ppe/W5300-for-QL/README

Hardware design and drivers for Sinclair QL experimental ethernet card.
