ppe/W5300-for-QL/Hardware/QE_PCB/QE_PCB.kicad_pcb

## KiCad design Hardware/QE_PCB/QE_PCB.kicad_pcb (2023-01-12)

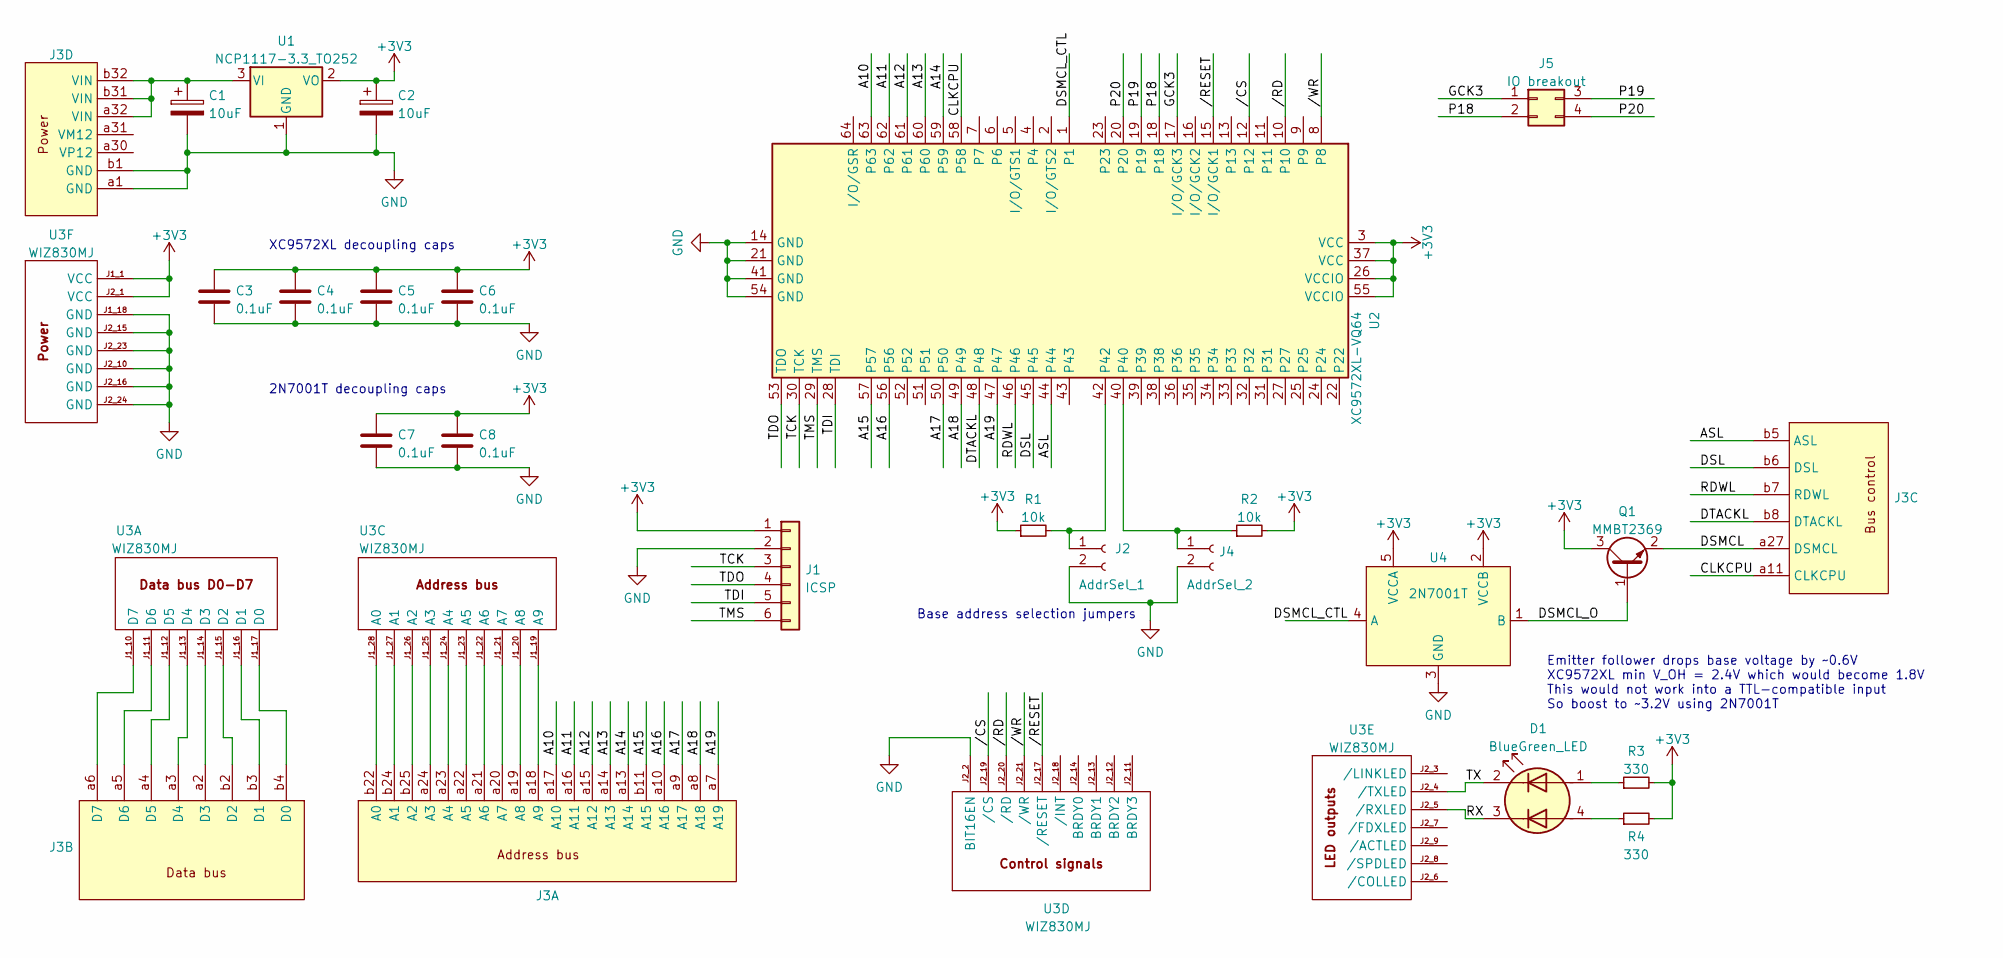
[picture p1: schematic QE_PCB.kicad_sch]

Parts:
C1, C2: 10uF; CP_EIA-6032-20_AVX-F_Pad2.25x2.35mm_HandSolder
C3, C4, C5, C6, C7, C8: 0.1uF; C_0603_1608Metric_Pad1.08x0.95mm_HandSolder
D1: BlueGreen_LED; LED_Dual_BG_2.0x1.25_Kingbright
J1: ICSP; PinHeader_1x06_P2.54mm_Vertical
J2: AddrSel_1; PinHeader_1x02_P2.54mm_Vertical
J3: Expansion_connector; DIN41612_B_2x32_Female_Horizontal_THT
J4: AddrSel_2; PinHeader_1x02_P2.54mm_Vertical
J5: IO breakout; PinHeader_1x04_P2.54mm_Vertical
Q1: MMBT2369; SOT-23
R1, R2: 10k; R_0805_2012Metric_Pad1.20x1.40mm_HandSolder
R3, R4: 330; R_0805_2012Metric_Pad1.20x1.40mm_HandSolder
U1: NCP1117-3.3_TO252; NCP1117 TO-252-2
U2: XC9572XL-VQ64; TQFP-64_10x10mm_P0.5mm
U3: WIZ830MJ
U4: 2N7001T; SOT-353_SC-70-5_Handsoldering

Connections:
+3V3: C2.1, C3.1, C4.1, C5.1, C6.1, C7.1, C8.1, J1.1, Q1.3 (C), R1.1, R2.2, R3.2, R4.2, U1.2 (VO), U2.3 (VCC), U2.26 (VCCIO), U2.37 (VCC), U2.55 (VCCIO), U3.J1_1 (VCC), U3.J2_1 (VCC), U4.2 (VCCB), U4.5 (VCCA)
/A10: J3.a17 (A10), U2.63
/A11: J3.a16 (A11), U2.62
/A12: J3.a15 (A12), U2.61
/A13: J3.a14 (A13), U2.60
/A14: J3.a13 (A14), U2.59
/A15: J3.b11 (A15), U2.57
/A16: J3.a10 (A16), U2.56
/A17: J3.a9 (A17), U2.50
/A18: J3.a8 (A18), U2.49
/A19: J3.a7 (A19), U2.47
/ASL: J3.b5 (ASL), U2.44
/CLKCPU: J3.a11 (CLKCPU), U2.58
/DSL: J3.b6 (DSL), U2.45
/DSMCL: J3.a27 (DSMCL), Q1.2 (E)
/DSMCL_CTL: U2.1, U4.4 (A)
/DSMCL_O: Q1.1 (B), U4.1 (B)
/DTACKL: J3.b8 (DTACKL), U2.48
/GCK3: J5.1, U2.17 (I/O/GCK3)
/P18: J5.2, U2.18
/P19: J5.3, U2.19
/P20: J5.4, U2.20
/RDWL: J3.b7 (RDWL), U2.46
/RX: D1.3 (K2), U3.J2_5 (/RXLED)
/TCK: J1.3, U2.30 (TCK)
/TDI: J1.5, U2.28 (TDI)
/TDO: J1.4, U2.53 (TDO)
/TMS: J1.6, U2.29 (TMS)
/TX: D1.2 (K1), U3.J2_4 (/TXLED)
//CS: U2.12, U3.J2_19 (/CS)
//RD: U2.10, U3.J2_20 (/RD)
//RESET: U2.15 (I/O/GCK1), U3.J2_17 (/RESET)
//WR: U2.8, U3.J2_21 (/WR)
GND: C1.2, C2.2, C3.2, C4.2, C5.2, C6.2, C7.2, C8.2, J1.2, J2.2, J3.a1 (GND), J3.b1 (GND), J4.2, U1.1 (GND), U2.14 (GND), U2.21 (GND), U2.41 (GND), U2.54 (GND), U3.J1_18 (GND), U3.J2_2 (BIT16EN), U3.J2_10 (GND), U3.J2_15 (GND), U3.J2_16 (GND), U3.J2_23 (GND), U3.J2_24 (GND), U4.3 (GND)
unnamed: C1.1, J3.a32 (VIN), J3.b31 (VIN), J3.b32 (VIN), U1.3 (VI)
unnamed: D1.1 (A1), R3.1
unnamed: D1.4 (A2), R4.1
unnamed: J2.1, R1.2, U2.42
unnamed: J3.a2 (D3), U3.J1_14 (D3)
unnamed: J3.a3 (D4), U3.J1_13 (D4)
unnamed: J3.a4 (D5), U3.J1_12 (D5)
unnamed: J3.a5 (D6), U3.J1_11 (D6)
unnamed: J3.a6 (D7), U3.J1_10 (D7)
unnamed: J3.a18 (A9), U3.J1_19 (A9)
unnamed: J3.a19 (A8), U3.J1_20 (A8)
unnamed: J3.a20 (A7), U3.J1_21 (A7)
unnamed: J3.a21 (A6), U3.J1_22 (A6)
unnamed: J3.a22 (A5), U3.J1_23 (A5)
unnamed: J3.a23 (A4), U3.J1_24 (A4)
unnamed: J3.a24 (A3), U3.J1_25 (A3)
unnamed: J3.b2 (D2), U3.J1_15 (D2)
unnamed: J3.b3 (D1), U3.J1_16 (D1)
unnamed: J3.b4 (D0), U3.J1_17 (D0)
unnamed: J3.b22 (A0), U3.J1_28 (A0)
unnamed: J3.b24 (A1), U3.J1_27 (A1)
unnamed: J3.b25 (A2), U3.J1_26 (A2)
unnamed: J4.1, R2.1, U2.40

Notes on the sheet:
Emitter follower drops base voltage by ~0.6V XC9572XL min V_OH = 2.4V which would become 1.8V This would not work into a TTL-compatible input So boost to ~3.2V using 2N7001T
XC9572XL decoupling caps
Base address selection jumpers
2N7001T decoupling caps

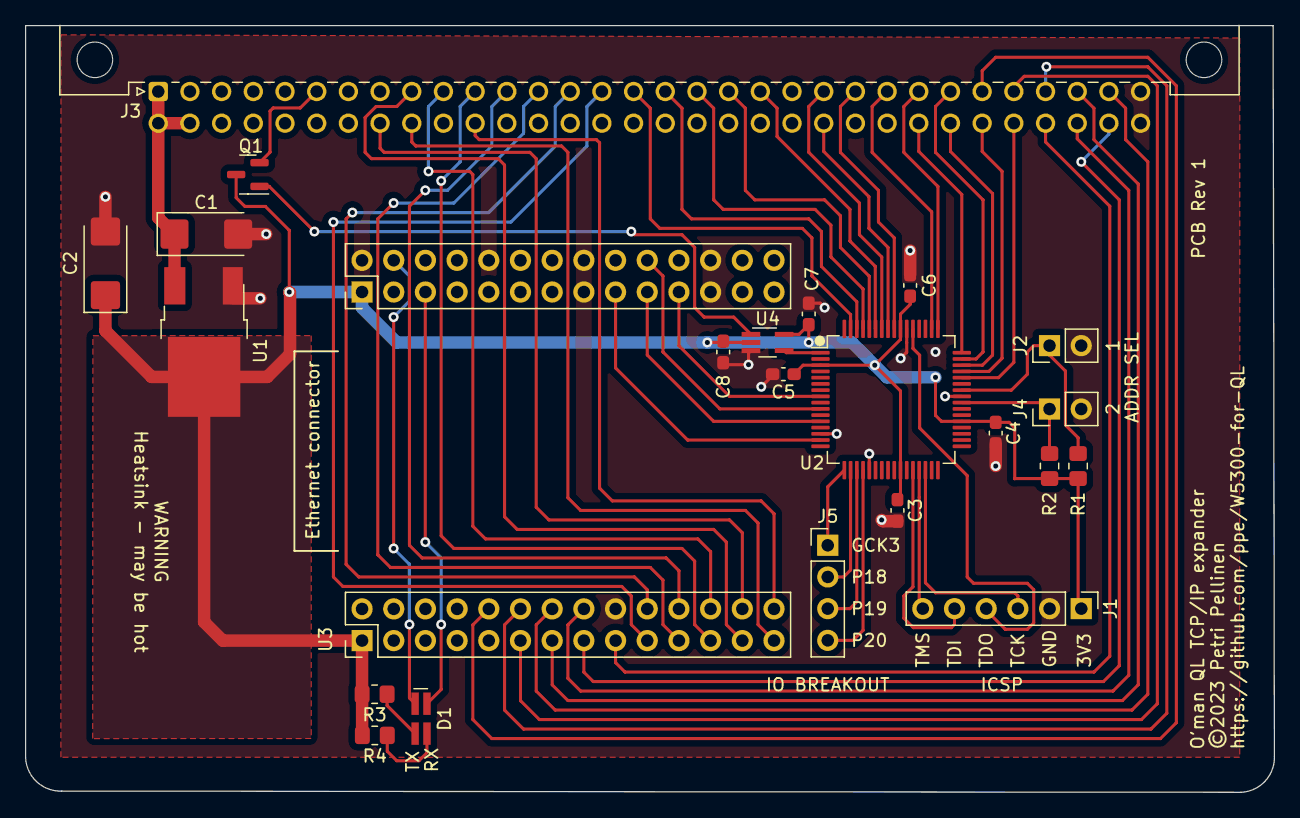
[picture p2: board QE_PCB.kicad_pcb from above]

Board: 2 copper layers, 100.1 x 61.5 mm, 23 parts (0 on the bottom side), 57 nets.
