ppe/W5300-for-QL/Hardware/Eagle/QL Ethernet/qe.brd

## EAGLE design Hardware/Eagle/QL Ethernet/qe.brd (2014-01-23)

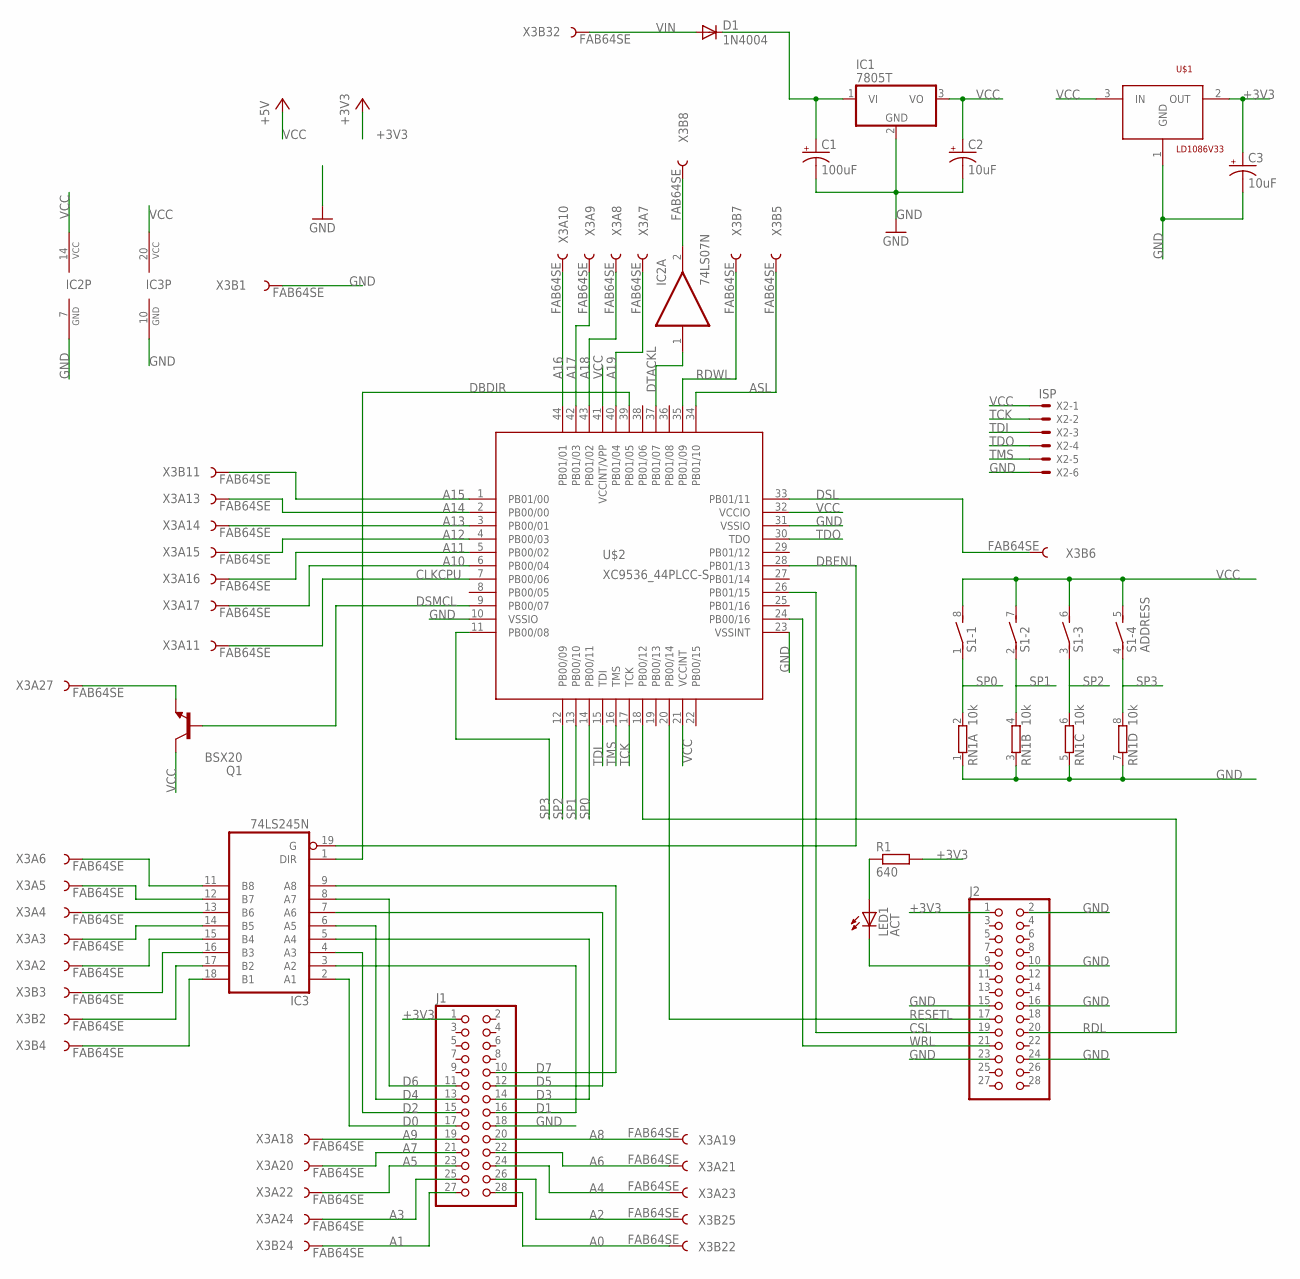
[picture p3: schematic qe.sch]

Parts:
C1: 100uF; TAP5-80
C2, C3: 10uF; TAP5-45
D1: 1N4004; DO41-10
IC1: 7805T; TO220H
IC2: 74LS07N; DIL14
IC3: 74LS245N; DIL20
J1, J2: PINHD-2X14; 2X14
LED1: ACT; LED5MM
Q1: BSX20; TO18
R1: 640; 0204/7
RN1: 10k; SIL8
S1: ADDRESS; DIP04S
U$1: LD1086V33; TO220
U$2: XC9536_44PLCC-S; PLCC44-S
X2: ISP; 22-23-2061
X3: FAB64SE; FAB64S

Connections:
+3V3: C3.+, J1.1, J2.1, R1.2, U$1.2 (OUT)
A0: J1.28, X3.B22
A1: J1.27, X3.B24
A2: J1.26, X3.B25
A3: J1.25, X3.A24
A4: J1.24, X3.A23
A5: J1.23, X3.A22
A6: J1.22, X3.A21
A7: J1.21, X3.A20
A8: J1.20, X3.A19
A9: J1.19, X3.A18
A10: U$2.6 (PB00/04), X3.A17
A11: U$2.5 (PB00/02), X3.A16
A12: U$2.4 (PB00/03), X3.A15
A13: U$2.3 (PB00/01), X3.A14
A14: U$2.2 (PB00/00), X3.A13
A15: U$2.1 (PB01/00), X3.B11
A16: U$2.44 (PB01/01), X3.A10
A17: U$2.42 (PB01/03), X3.A9
A18: U$2.43 (PB01/02), X3.A8
A19: U$2.40 (PB01/04), X3.A7
ASL: U$2.34 (PB01/10), X3.B5
CLKCPU: U$2.7 (PB00/06), X3.A11
CSL: J2.19, U$2.26 (PB01/15)
D0: IC3.2 (A1), J1.17
D1: IC3.3 (A2), J1.16
D2: IC3.4 (A3), J1.15
D3: IC3.5 (A4), J1.14
D4: IC3.6 (A5), J1.13
D5: IC3.7 (A6), J1.12
D6: IC3.8 (A7), J1.11
D7: IC3.9 (A8), J1.10
DBDIR: IC3.1 (DIR), U$2.39 (PB01/05)
DBENL: IC3.19 (G), U$2.28 (PB01/13)
DSL: U$2.33 (PB01/11), X3.B6
DSMCL: Q1.2 (B), U$2.9 (PB00/07)
DTACKL: IC2.1 (I), U$2.37 (PB01/07)
GND: C1.-, C2.-, C3.-, IC1.2 (GND), IC2.7 (GND), IC3.10 (GND), J1.18, J2.2, J2.10, J2.15, J2.16, J2.23, J2.24, RN1.1, RN1.3 (1), RN1.5 (1), RN1.7 (1), U$1.1 (GND), U$2.10 (VSSIO), U$2.23 (VSSINT), U$2.31 (VSSIO), X2.6, X3.B1
unnamed: IC3.11 (B8), X3.A6
unnamed: IC3.12 (B7), X3.A5
unnamed: IC3.13 (B6), X3.A4
unnamed: IC3.14 (B5), X3.A3
unnamed: IC3.15 (B4), X3.A2
unnamed: IC3.16 (B3), X3.B3
unnamed: IC3.17 (B2), X3.B2
unnamed: IC3.18 (B1), X3.B4
unnamed: Q1.1 (E), X3.A27
unnamed: J2.9, LED1.K (C)
unnamed: LED1.A, R1.1
unnamed: D1.A, X3.B32
unnamed: IC2.2 (O), X3.B8
RDL: J2.20, U$2.18 (PB00/12)
RDWL: U$2.35 (PB01/09), X3.B7
RESETL: J2.17, U$2.20 (PB00/14)
SP0: RN1.2, S1.1, U$2.14 (PB00/11)
SP1: RN1.4 (2), S1.2 (1), U$2.13 (PB00/10)
SP2: RN1.6 (2), S1.3 (1), U$2.12 (PB00/09)
SP3: RN1.8 (2), S1.4 (1), U$2.11 (PB00/08)
TCK: U$2.17 (TCK), X2.2
TDI: U$2.15 (TDI), X2.3
TDO: U$2.30 (TDO), X2.4
TMS: U$2.16 (TMS), X2.5
VCC: C2.+, IC1.3 (VO), IC2.14 (VCC), IC3.20 (VCC), Q1.3 (C), S1.5 (2), S1.6 (2), S1.7 (2), S1.8 (2), U$1.3 (IN), U$2.21 (VCCINT), U$2.32 (VCCIO), U$2.41 (VCCINT/VPP), X2.1
VIN: C1.+, D1.C, IC1.1 (VI)
WRL: J2.21, U$2.24 (PB00/16)

Board: 2 copper layers, 18 parts (0 on the bottom side), 65 nets, no tracks yet.
