ppe/W5300-for-QL/(threads)

Thread 2 (2022-12-06):

Problem compiling driver

SM7I, 2022-12-06:
I´m having issues compiling the driver with the docker xora/qdos-gcc. I´ll try it on my full blown compiler later and see if it works there.

ppe, 2022-12-06:
Pointed to new driver source at https://github.com/ppe/QE_driver.

SM7I confirmed he was able to compile the driver with the new source.

Closed 2022-12-06.
