ppe/W5300-for-QL/(commit log)

2011-02-28 Initial import of W5300 specific code and start of device driver
2011-03-01 Driver name comparison work. Added the missing constatnts file
2011-03-08 Added driver name parser that recognizes udp driver names with a numeric ip address and port
2011-03-20 Added nslookup superbasic extension. Currently it only creates a buffer that contains the dns query message.
2011-03-20 Added socket open code to socket layer
2012-01-19 WIP on prototype circuit board
2014-01-22 Add i2c and spi test code to debug project.
2014-01-23 Add Eagle 6.4 schematics for the prototype adapter.
    [qe.brd, qe.sch]
2014-01-23 Add library for the 3.3V regulator part used on the prototype board.
2014-01-26 Change include file device name to be parameterized.
2014-01-27 Fix return code for open call when driver name does not match.
2014-01-27 Fix driver name pointer on return from host name parse.
2014-03-26 Refactor driver name parsing code.
2014-11-17 Change base addressess to C8000 (card) and C9000 (reset)
    [QeControl.v]
2014-11-17 Fix W5300 reset logic and add test for it.
    [QeControl.v, QeControlTest.v, ResetTest.v, W5300Reset.v]
2014-11-17 Fix gating, ack and dsmcl logic.
    [QeControl.v]
2014-11-17 Fix misunderstood timing and signalling for W5300. Best version so far
    [QeControl.v, QeControlTest.v]
2014-12-06 Remove test printf.
2014-12-31 WIP: start working on new version of driver
2015-01-07 QE_UNLOAD unloads driver and releases allocated heap.
2015-01-08 Add stub function for nslookup keyword in driver
2015-01-11 add parameter validation to nslookup$ function, remove debug print to #0.
2015-01-11 Add to NSLOOKUP$: copy parameter to driver temporary buffer.
2015-01-11 Add user heap initialization to driver init.
2015-01-12 Change NSLOOKUP$: use LINK and frame pointer for local variable storage.
2015-01-17 nslookup$ use results from gethostbyname. TODO: change stack-based frame pointer to a user heap based one.
2015-01-28 Add W5300 HW layer file and call HW init from driver init.
2015-01-29 driver init: initialize a socket reservation table in driver linkage block.
2015-01-29 gethostbyname: change local vars to use frame pointer in preparation for socket reservation code.
2015-01-30 gethostbyname: add socket reservation to lookup
2015-01-30 gethostbyname: add release socket reservation.
2015-01-31 w5300: add open routine for UDP sockets. Support ERR_NC and continuation.
2015-02-01 Add socket close operation.
2015-02-01 Close and release sockets when closing channel and/or starting new IO op on channel after timeout.
2015-02-03 Add _list and _rel files to .gitignore to prepare for qmac assembler
2015-02-03 Change w5300_asm source to qmac assembler format.
2015-02-03 Add skeleton makefile for driver.
2015-02-05 Change driver_asm to qmac format.
2015-02-05 Makefile: add dependency to driver_asm
2015-02-05 Makefile: add linking instruction for driver target.
2015-02-07 Add stub to set destination for a socket.
2015-02-08 Fix the routine to write bytes to a socket.
2015-02-09 Add logic to open a UDP socket (without destination info).
2015-02-10 Fix socket close sending wrong command to W5300.
2015-02-11 Fix socket number parameter in socket close.
2015-02-14 WIP on read bytes from socket.
2016-04-21 Add (partly broken) prototype irc client
2016-04-21 Refactor driver to be hybrid c/asm driver
2023-01-12 PCB Rev 1
    [QE_PCB-B_Cu.gbr, QE_PCB-B_Mask.gbr, QE_PCB-B_Paste.gbr, QE_PCB-B_Silkscreen.gbr, QE_PCB-Edge_Cuts.gbr, QE_PCB-F_Cu.gbr, QE_PCB-F_Mask.gbr, QE_PCB-F_Paste.gbr]
