ppe/W5300-for-QL/(notices)

Notices in the files:
Hardware/QE_PCB/QE_PCB.kicad_pcb:
©2023 Petri Pellinen
